JonDeMartini/PersonalClimateControl/images/BluefruitConnect-Plotter.PNG

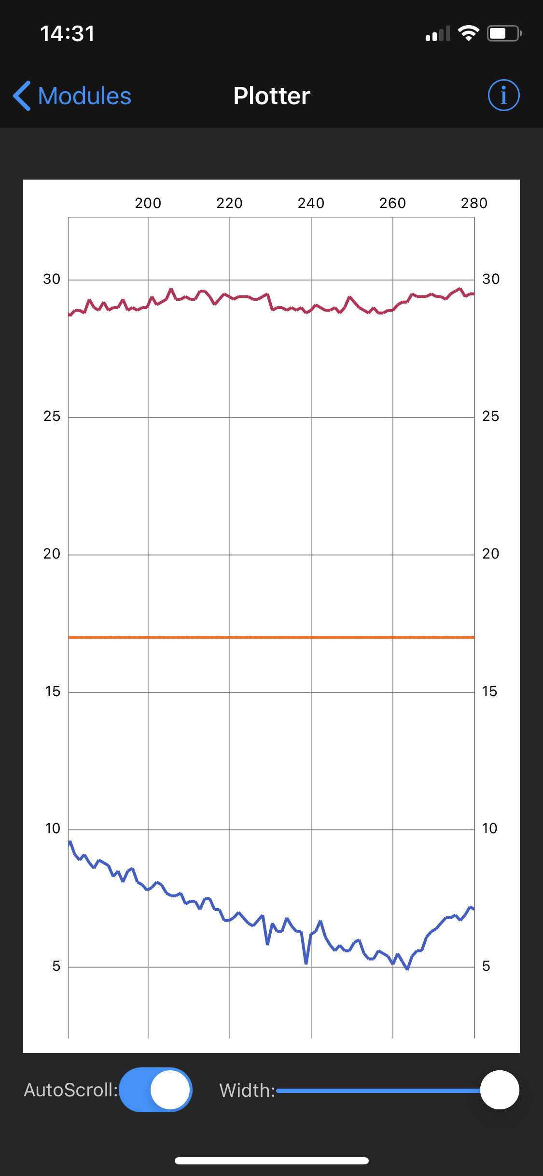
images/BluefruitConnect-Plotter.PNG
