JonDeMartini/PersonalClimateControl/images/BluefruitConnect.JPG

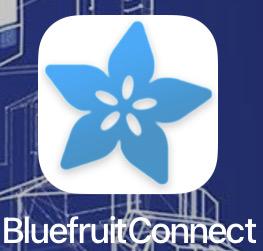
images/BluefruitConnect.JPG
