JonDeMartini/PersonalClimateControl/images/BluefruitControlPad.PNG

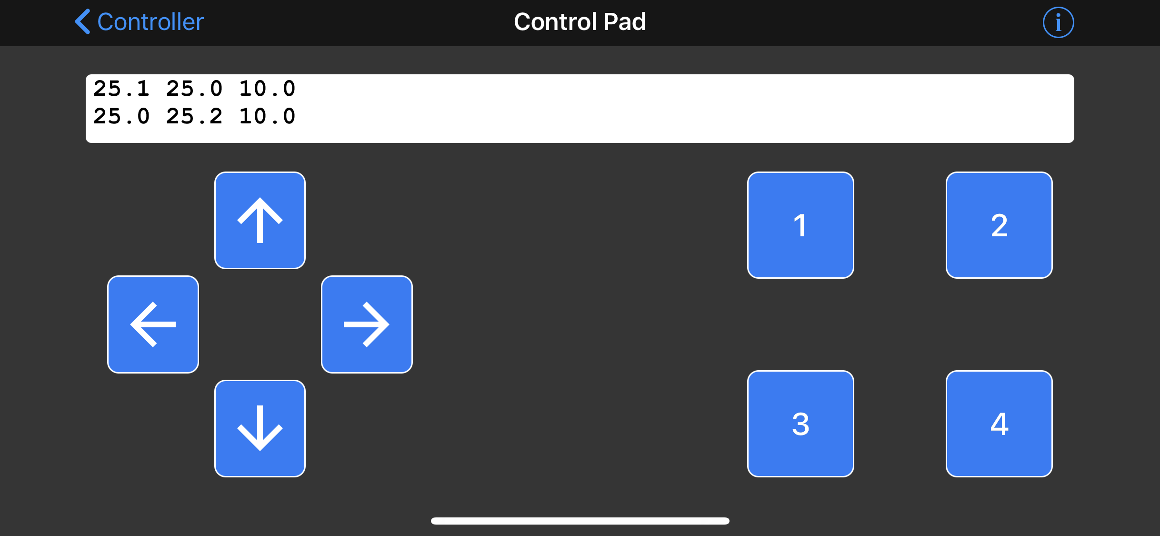
images/BluefruitControlPad.PNG
