JonDeMartini/PersonalClimateControl/images/Personal_Climate_Control.jpg

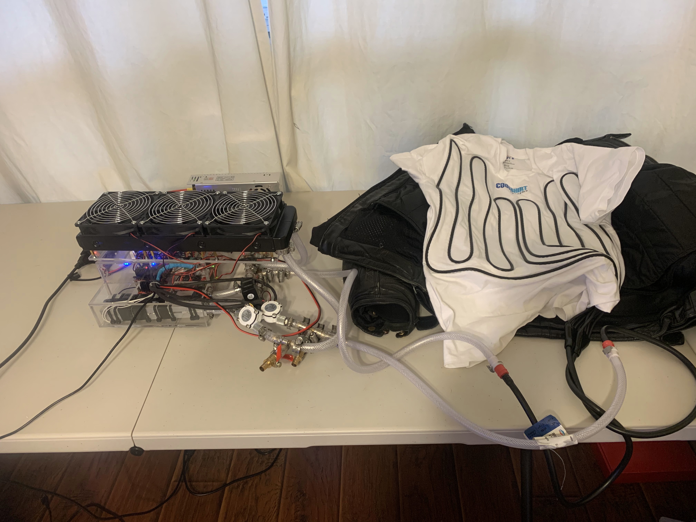
images/Personal_Climate_Control.jpg
