JonDeMartini/PersonalClimateControl/Presentation/Personal Climate Control - Presentation/Slide2.PNG

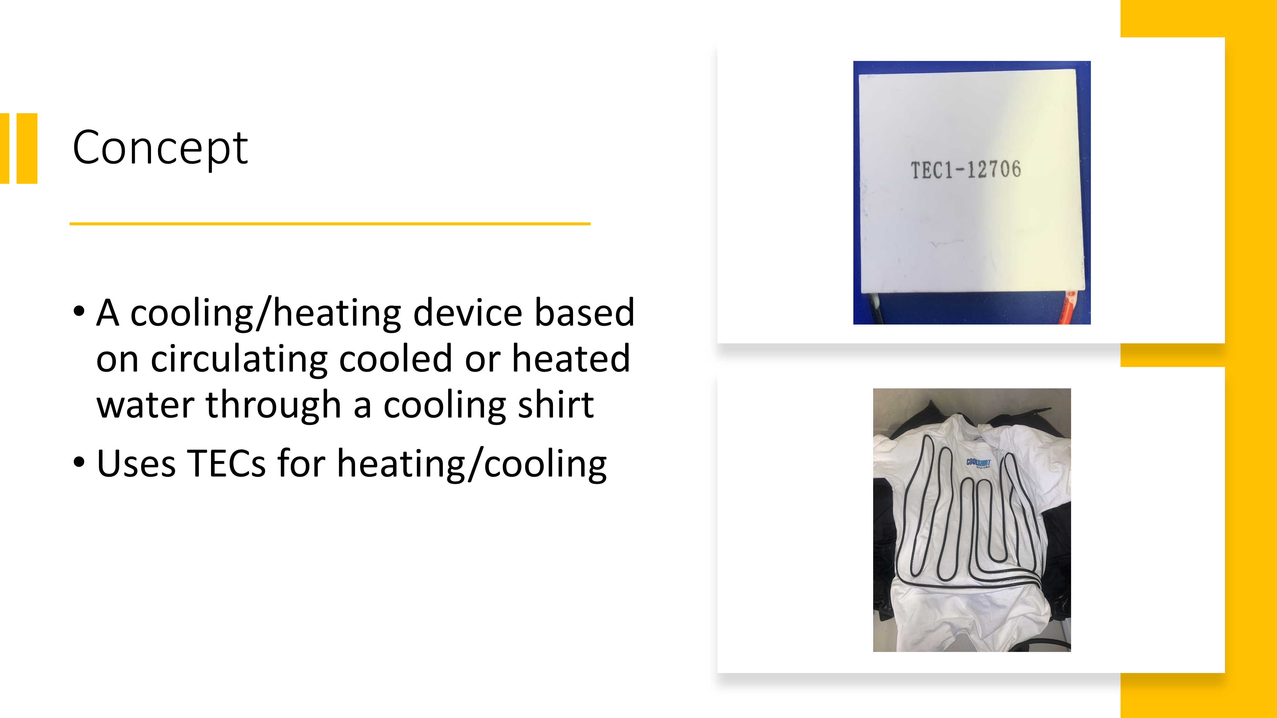
Presentation/Personal Climate Control - Presentation/Slide2.PNG
