JonDeMartini/PersonalClimateControl/Presentation/Personal Climate Control - Presentation/Slide3.PNG

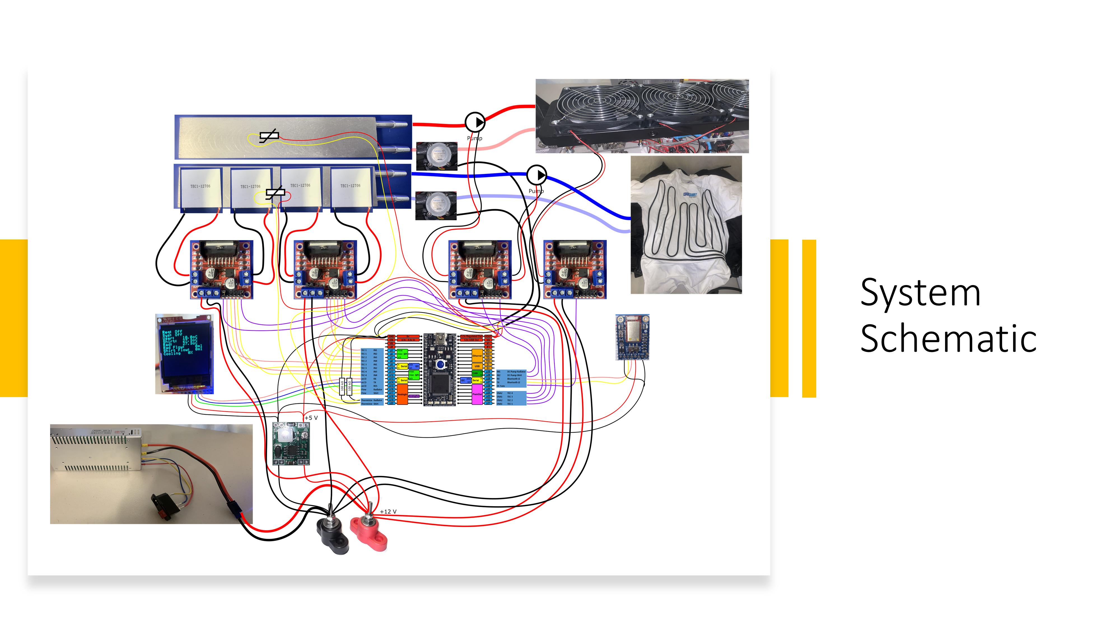
Presentation/Personal Climate Control - Presentation/Slide3.PNG
