JonDeMartini/PersonalClimateControl/Presentation/Personal Climate Control - Presentation/Slide4.PNG

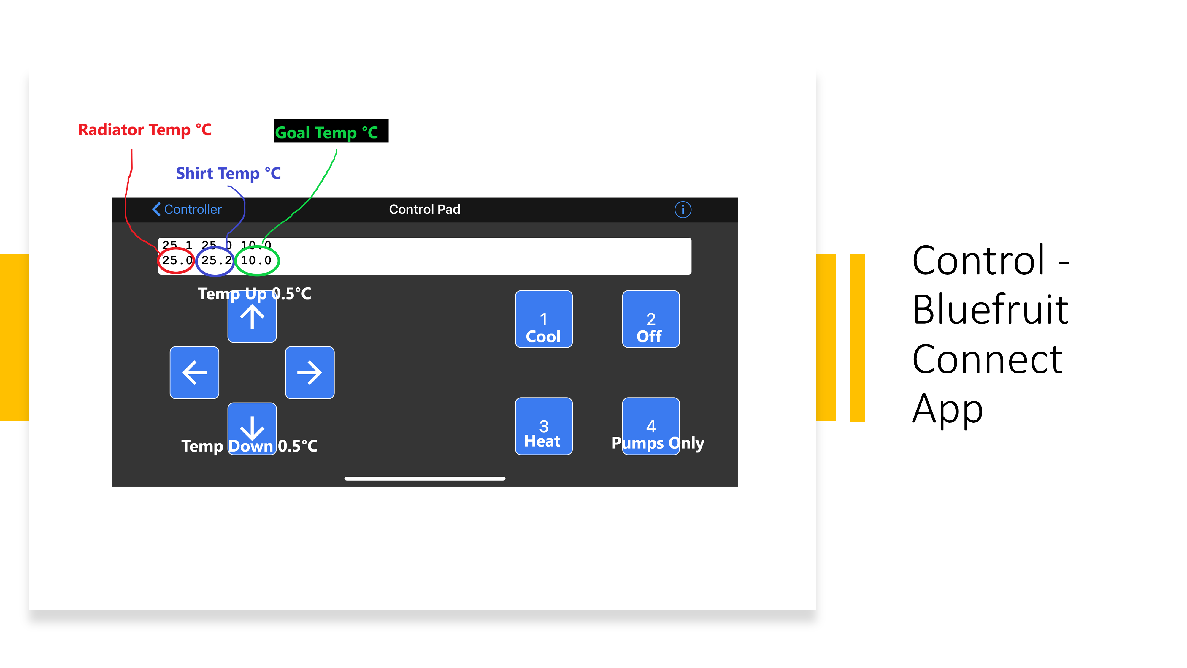
Presentation/Personal Climate Control - Presentation/Slide4.PNG
