JonDeMartini/PersonalClimateControl/Presentation/Personal Climate Control - Presentation/Slide5.PNG

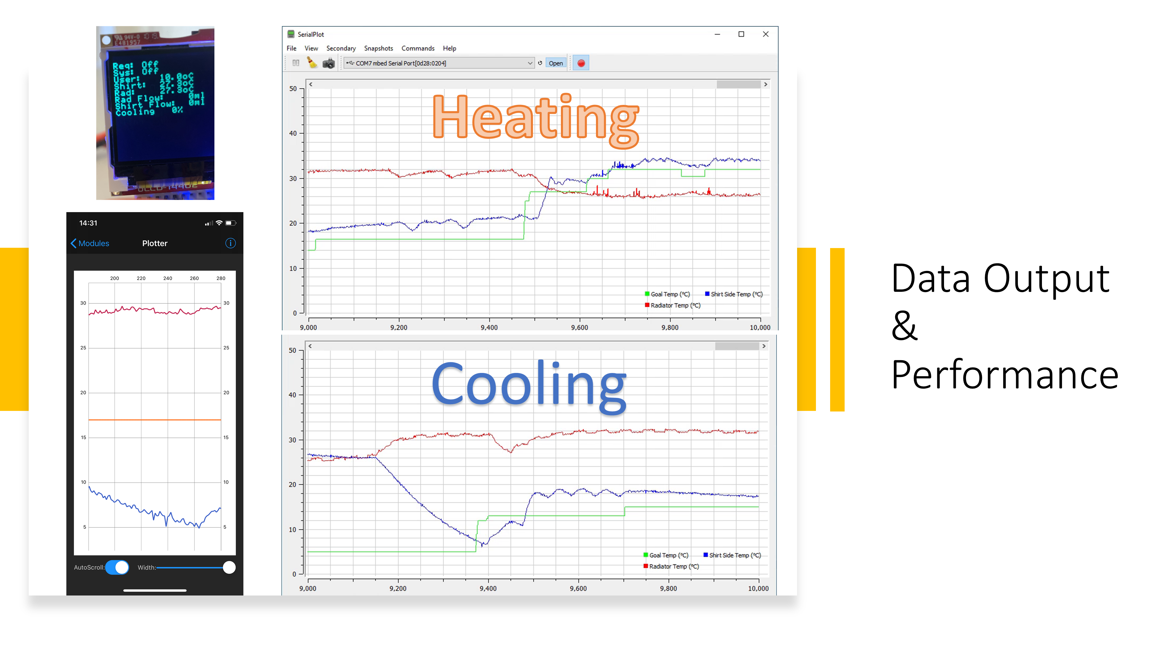
Presentation/Personal Climate Control - Presentation/Slide5.PNG
