JonDeMartini/PersonalClimateControl/Presentation/Personal Climate Control - Presentation/Slide6.PNG

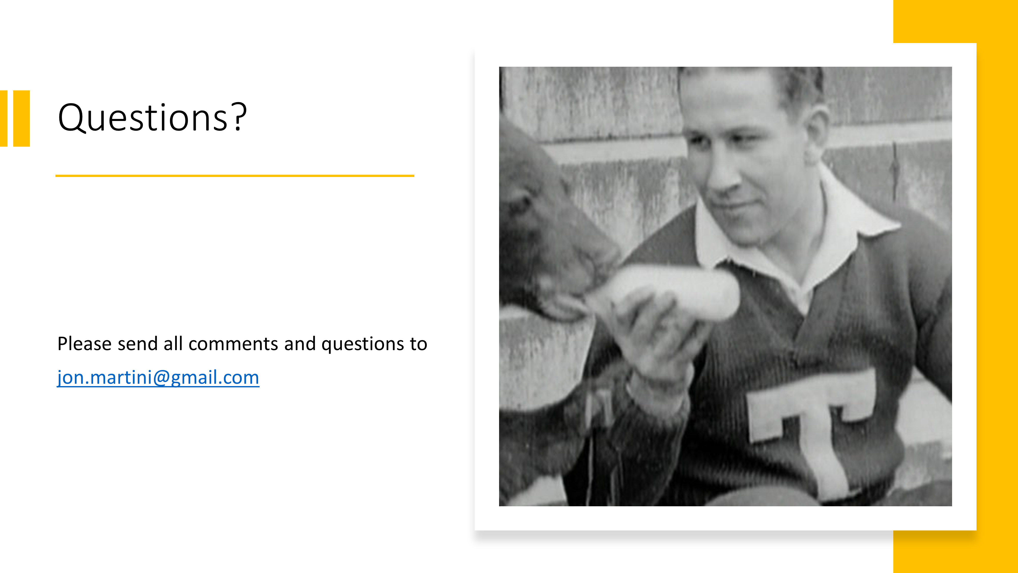
Presentation/Personal Climate Control - Presentation/Slide6.PNG
